Senekw/latch-knee/paper/latch_knee_paper.html

# LATCH: a load-sequence-sensing, any-angle stance-control knee joint for KAFOs — design and validation report

Design package and analysis report

October 2026

# Abstract

People with quadriceps paralysis (polio survivors, incomplete spinal-cord injury, stroke) usually walk in knee–ankle–foot orthoses (KAFOs) whose knee is locked straight for the whole gait cycle, forcing hip hiking, circumduction and vaulting. Stance-control knee joints that free the knee in swing cost US$1,700–3,500 per joint and the only purely mechanical ones either need a cable from the ankle or a gravity pendulum that locks only at full extension. We asked whether a knee joint can decide stance from swing using only the loads it already carries. Using a public multi-speed walking dataset (51 subjects, 381 treadmill trials, 0.34–2.23 m/s) we first showed that any pendulum trigger mounted on the thigh is corrupted by the knee’s own accelerations (up to 14 m/s^2 at toe-off), so that no pendulum length, mount height or damping achieved both reliable locking at heel strike and release before swing. We then designed a joint in which a fine-pitch ratchet (3.75^\circ resolution, locks at any knee angle) is engaged and released by the sign sequence of the external knee moment: a flexion load on the pawls sets a mechanical latch, a subsequent extension load on a sprung hyperextension stop releases the pawls, a friction drag ring on the knee axle keeps them lifted while the knee flexes in swing and drops them during swing extension, and two rotary dampers and a dashpot provide the required 0.1–0.3 s time constants. Simulated on 9,781 valid strides with a causal state machine driven by measured knee kinematics and inverse-dynamics moments, the design locked at heel strike in 99.2% of strides at speeds \le1.5 m/s, was unlocked while a buckling load was present in 0.27%, falsely blocked swing flexion in 0.23%, released before pre-swing flexion in 89.6% and never released in 3.6% (a safe, stiff-knee stride). The knee angle at heel strike in the dataset was 7.4\pm6.0^\circ (64% of strides >5^\circ), which quantifies why single-notch full-extension locks fail. The complete joint is modelled parametrically (22 components, STEP and STL supplied): a laser-cut steel load path (two phased toothed clevis plates, 3-tooth hook pawls, 12 mm pin) with 3D-printed control parts, bill of materials US$74, plane-stress FE peak tooth stress 250–280 MPa at the 70 N\cdotm design moment and 540–600 MPa at a 150 N\cdotm proof moment (17-4PH H900 yield 1,170 MPa). We give the full validation protocol for bench and gait-laboratory testing.

# Introduction

## The problem

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

## Stance-control joints and why they are rare

Stance-control knee–ankle–foot orthoses (SCKAFOs) lock the knee only while the leg bears weight and free it in swing. They normalise kinematics reliably even if the energy-cost benefit is modest [12, 13, 14, 6]. Commercial joints fall into three families. (i) Cable-released joints (Ottobock FreeWalk, Becker UTX/Stride family) unlock when the ankle dorsiflexes in late stance and lock only when the knee reaches full extension [6]; (ii) the Fillauer Swing Phase Lock (SPL2) uses an internal gravity pendulum that drops a pawl into a single notch at full extension when the thigh is inclined forward [15]; (iii) sensor-based electromechanical and microprocessor joints (E-MAG, NEURO TRONIC, C-Brace) that cost from €10,000 to US$37,000 as finished orthoses and still show 10–14% unlock failures per step under challenging conditions [16, 17, 18]. Bare mechanical joint systems list at about US$1,700 (FreeWalk kit) to £3,500 (SPL2) [19, 20]. The recurring engineering limitation identified by Yakimovich et al. is “dependence on specific joint angles to switch between stance and swing modes” [6]: a user who falls short of full extension in terminal swing is left unsupported [21]. Becker markets the SafetyStride specifically as resisting flexion at any angle [22]; research joints with any-angle capability have used hydraulics (69 N\cdotm [23]), a linear piston resisting >150 N\cdotm [24], a quasi-passive spring clutch [25], a three-tooth 10^\circ-pitch ratchet [21], and most recently a low-cost solenoid-driven serrated ring [26]. None of these is simultaneously any-angle, electronics-free, cable-free, pendulum-free and open.

## Contribution

This report presents LATCH (Load-Actuated, Thigh-Cable-free, any-angle stance-Control Hinge), a KAFO knee joint that decides stance from swing using only the external knee moment it already carries, with no pendulum, cable, battery or sensor. Three things are new. First, a data-driven negative result that motivates the design: driven by the measured kinematics of 51 subjects, a thigh-mounted pendulum cannot be made reliable at any length, mount height or damping (Section 3.1). Second, a load-sequence stance detector that is realisable with two springs, a friction ring, two rotary dampers and a dashpot, and whose per-stride performance we quantify on 9,781 strides across eight speeds (Section 3.2). Third, a complete parametric design package (CAD, finite-element sizing, bill of materials, assembly and validation protocol) that uses laser-cut steel for the load path and 3D printing for the control mechanism, at a parts cost of US$74 (Sections 4–5).

# Methods

## Gait data

We used the Fukuchi et al. public walking dataset [27] (“WBDS”; figshare 10.6084/m9.figshare.5722711, v3 release containing 51 adult subjects), restricted to its treadmill trials: eight speeds per subject (40–145% of comfortable speed), 30 s each, giving 381 trials with 150 Hz marker trajectories, 300 Hz split-belt force plates and gait-cycle-normalised joint moments from inverse dynamics. From the markers we computed, for the right leg, the thigh inclination from vertical \theta (greater trochanter to lateral knee marker), the knee flexion angle (thigh versus shank segments), and the position and acceleration of points on the lateral thigh upright 0–20 cm above the knee axis, after 8 Hz low-pass filtering. Right heel strikes and toe-offs were detected as force-plate contacts validated by the centre of pressure lying within 18 cm of the right heel and ankle markers. Strides with implausible stance fraction (<50\% or >72\% of the cycle) or duration (outside 0.6–2.4 s) were excluded, leaving 9,781 strides from 51 subjects at 0.34–2.23 m/s (mean body mass 67.8 kg). The knee moment curve of each trial (N\cdotm/kg; positive = internal extensor = external flexion load) was mapped onto each stride by percentage of cycle.

## Mechanism simulation

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

#### Pendulum trigger.

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

#### Load-sequence trigger (LATCH).

The joint has three mechanical inputs: the external flexion moment carried by the engaged pawls; the external extension moment carried by a sprung hyperextension stop with 1 mm of travel before a hard stop; and the direction of knee rotation sensed by a friction-drag ring on the knee axle with a dead band \delta. The logic (Fig. 2) is: (1) a pawl load above M_\mathrm{pawl} sets a LATCH that decays T_\mathrm{latch} after the pawl unloads (rotary damper); (2) a stop load above M_\mathrm{thr} while LATCH is set, or sustained for longer than T_\mathrm{long} (dashpot timer), lifts the pawls and keeps them lifted while the stop remains loaded; (3) the drag ring holds the pawls lifted while the knee flexes and lets them drop, after a delay t_\mathrm{drop} set by a second rotary damper, once the knee has extended by \delta; (4) the ratchet teeth cover knee angles -5^\circ to 30^\circ, so pawls dropped at larger flexion ride a smooth rim and engage on reaching the toothed sector. Thresholds are per kilogram of body mass and are set on the device by spring preload screws. The design point is M_\mathrm{thr}=0.05, M_\mathrm{pawl}=0.08 N\cdotm/kg, T_\mathrm{latch}=0.15 s, T_\mathrm{long}=0.30 s, \delta=15^\circ, t_\mathrm{drop}=0.10 s, t_\mathrm{lift}=0.03 s.

#### Outcome measures (per stride).

Locked at heel strike: pawls engaged at the next heel strike and 20 ms later. Buckling exposure: any instant before the pre-swing flexion onset at which the knee is unlocked while the external flexion moment exceeds 0.05 N\cdotm/kg. False lock: pawls engaged while the knee is flexing in swing. Released in time: pawls released before the knee needs to flex 5^\circ beyond its mid-stance minimum. Stiff stride: no release before toe-off (safe failure). We also report the release instant and the ratcheting travel (clicks) per stride.

## CAD, structural sizing and finite elements

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

# Results

## Why a single-notch lock fails and why a pendulum cannot fix it

Knee flexion at heel strike across the 9,781 strides was 7.4\pm6.0^\circ (5th–95th percentile -0.7 to 18.1^\circ); 64% of strides exceeded 5^\circ and 28% exceeded 10^\circ (Fig. 1A). A lock with a single notch at full extension therefore depends on the orthotist’s alignment and on the user reaching that one angle every step; an any-angle lock removes the dependence.

A gravity pendulum reads the direction of apparent gravity g-a, not of g. Fig. 1B shows, for one subject at 1.24 m/s, that the forward acceleration of the knee at toe-off (peaks of 9–14 m/s^2 at the knee, 5–7 m/s^2 20 cm up the thigh) tilts apparent gravity by 40–55^\circ and its deceleration in terminal swing by 20–40^\circ, in each case in the direction that mimics the opposite gait phase. Across the full sweep (Fig. 1C and sweep1.csv) the best pendulum for locking (8 cm, 20 cm mount, \zeta=3) locked at heel strike in 99.7% of strides but released before swing in only 2.5%; the best for releasing (3 cm at the knee, \zeta=0.3) released in 84% but engaged the ratchet during swing flexion in 53% of strides. Long pendulums (L_\mathrm{eff}\ge 20 cm) remove the thigh-rotation component but sit near resonance with the stride-frequency hip acceleration and miss the 130 ms release window. Slow, heavily damped pendulums are safe but functionally equivalent to a locked knee. This is the mechanism behind the alignment sensitivity reported for pendulum joints [15, 6], and it is a property of inertial sensing at the knee rather than of any particular product.

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

## The load-sequence stance detector

Fig. 2 shows the LATCH logic on a measured stride at 1.03 m/s. The pawls are engaged at heel strike. The initial-contact extension moment (the ground reaction passes in front of the knee for 50–80 ms) loads the stop but LATCH is not set, so nothing happens; during loading response the external flexion moment loads the pawls and sets LATCH; when the ground reaction moves in front of the knee at 23% of the cycle the stop is loaded while LATCH is live and the pawls lift. The knee is now free but rests against the extension stop, which carries an extension moment of 0.3–0.65 N\cdotm/kg through mid-stance: a knee under an external extension moment is self-stable, which is the biomechanical justification of releasing at this instant. At pre-swing the stop unloads and the knee flexes; the drag ring registers 15^\circ of flexion within the 100 ms pawl-drop delay and holds the pawls up through swing. At peak swing flexion the knee reverses, the ring releases the pawls after 15^\circ of extension, they ride the smooth rim and ratchet over the last 20^\circ (median 21.6^\circ of ratcheting, about six clicks at 3.75^\circ resolution) and the knee arrives at heel strike locked at whatever angle it reached.

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

Table 1 and Fig. 3 summarise performance. Within the speed range in which KAFO users walk (\le1.5 m/s; 7,278 strides, 51 subjects) the joint was locked at heel strike in 99.2% of strides, was exposed to a buckling load while unlocked in 0.27%, falsely blocked swing flexion in 0.23%, released before the knee needed to flex in 89.6%, released late but before toe-off in a further 6.8%, and never released (stiff-knee stride) in 3.6%. The median release instant was 28% of the cycle (5th–95th percentile 7–51%). Above 1.5 m/s performance degrades (locked at heel strike 89–93%, exposure 7–8%) through one specific chain: fast walkers develop a second external flexion moment in pre-swing that keeps the pawls loaded until toe-off, so LATCH is still live when the shank’s deceleration loads the stop in terminal swing and the joint releases just before heel strike. A hypothetical heel-strike impact detector that allowed LATCH to be set only within 0.5 s of heel strike would raise locking above 1.5 m/s to 98.2% and cut exposure to 0.9% at no cost in the envelope (Fig. 3C, lock_sensitivity.json); we list it as the first design iteration.

Per-stride performance of the design point. Envelope = speeds \le1.5 m/s. “Stiff” strides are counted in “not released in time”.
Speed band (m/s) | n | Locked at HS | Buckling exposure | False swing lock | Released in time | Stiff stride | Release (%GC)
0.50 | 873 | 94.6% | 0.0% | 0.6% | 93.2% | 3.4% | 14
0.69 | 1065 | 100.0% | 0.4% | 0.4% | 90.6% | 1.9% | 20
0.87 | 1188 | 99.3% | 0.0% | 0.5% | 86.4% | 3.1% | 32
1.06 | 1321 | 100.0% | 0.8% | 0.1% | 90.2% | 3.4% | 28
1.24 | 1445 | 99.7% | 0.3% | 0.1% | 87.0% | 6.2% | 29
1.43 | 1530 | 99.5% | 0.8% | 0.3% | 95.6% | 0.3% | 28
1.63 | 1234 | 89.1% | 7.7% | 4.6% | 92.5% | 5.3% | 25
1.79 | 1125 | 93.3% | 6.6% | 5.8% | 96.8% | 3.2% | 26
Envelope \le1.5 | 7278 | 99.2% | 0.27% | 0.23% | 89.6% | 3.6% | 28
All | 9781 | 97.2% | 2.0% | 1.5% | 91.5% | 3.4% | 28

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

The sensitivity study (Fig. 3C) gives three design rules. (i) Preload must err high: thresholds 30% too low reduce locking to 93.6% and raise exposure to 5.3%, whereas thresholds 30% too high keep 99.99% locking and 0.07% exposure at the price of 7.5% stiff strides; the preload screws should therefore be set from the user’s body mass and then backed off only until swing release is observed. (ii) The dashpot timer is essential: without it, strides whose loading-response flexion moment never exceeds M_\mathrm{pawl} (all slow walking, where the ground reaction stays in front of the knee) never release and 44% of envelope strides are stiff. (iii) The drag-ring dead band and pawl-drop delay are forgiving over \delta=10–20^\circ and t_\mathrm{drop}=60–150 ms, and a 0.3 N\cdotm/kg, 25 ms stop impulse at terminal swing (shank hitting the extension stop) changes nothing because LATCH is not live at that instant. Knee moment peaks in the dataset were 0.21 (median), 0.82 (95th) and 1.06 N\cdotm/kg (99th percentile) in flexion and 0.51/0.78 N\cdotm/kg in extension, which fixes the structural loads below.

# Mechanical design

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

## Load path

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

## Control deck (printed)

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

## Mass and cost

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

# Structural analysis

Design loads follow from Section 3.2 and the literature: a typical peak external flexion moment of 0.5 N\cdotm/kg (36 N\cdotm for 70 kg) for fatigue, the 99th-percentile 1.0 N\cdotm/kg (70 N\cdotm) as design moment, and 150 N\cdotm as proof moment, the latter matching the Ottawa piston joint that was designed for >150 N\cdotm and survived 400,000 cycles [24]. Plane-stress finite elements of the toothed plate (Fig. 6) give a von Mises stress at the loaded tooth roots of 250–280 MPa (99th–99.5th percentile of element stresses) at 70 N\cdotm and 540–600 MPa at 150 N\cdotm, with a sharp-corner singular maximum of 570 and 1,215 MPa respectively that a 0.4 mm root fillet removes. For 17-4PH H900 (yield 1,170 MPa, fully reversed fatigue limit about 550 MPa) or through-hardened 1095 this gives a yield safety factor of 2.0 at the proof moment and a fatigue safety factor above 3 at the typical load (root stress about 140 MPa). The analytical checks are: tooth tangential force 2,170 N at 70 N\cdotm; 6 mm pawl pin in double shear 38 MPa, bearing in the 6 mm thigh plate 60 MPa (129 MPa at proof); 12 mm knee pin resultant 3.1 kN, bronze bushing bearing 52 MPa per plate (93 MPa at proof); 16\times6 mm thigh upright in sagittal bending 273 MPa if one upright carries the full 70 N\cdotm (137 MPa when shared). The FE result also explains why the load path cannot be printed: FFF polyamide-12 and polycarbonate have fatigue limits of 7.4 and 3.6 MPa [28] and even short-carbon-fibre polyamide reaches only 40–117 MPa in tension [29], two orders of magnitude below the tooth-root stress.

Plane-stress FE of the toothed shank plate at the 70 N\cdotm design moment (left) and 150 N\cdotm proof moment (right); 6,348 quadratic triangles, fixed at the bushing seat, the tangential tooth force shared 50/30/20% over the three engaged flanks.

# Discussion

## What the simulation does and does not show

The simulation is a kinematic/kinetic replay: real knee angles and inverse-dynamics moments of unimpaired walkers drive a causal model of the mechanism, with the knee angle clamped while the lock is engaged. It therefore tests the decision logic against the full variability of 51 people at eight speeds, which no bench test can do, but it does not model how a KAFO user’s hip and trunk would adapt to the joint, nor the compliance of the orthosis shells, nor friction and wear. Three systematic differences from a KAFO user should bias the results in a known direction. Quadriceps-weak users keep the ground reaction in front of the knee by trunk lean and hyperextension, so their stance moment is extension-dominated: the latch path fires less often and the timer path more often, which the slow-speed rows of Table 1 already represent. Their swing is slower and lower, which lengthens the pre-swing window and favours release in time. Their knee hits the extension stop at terminal swing, which the impulse test covers. The one chain that limits fast-walking performance (pre-swing flexion load keeping LATCH live into terminal swing) is specific to vigorous push-off and is unlikely in the target population, but the heel-strike gate that removes it is a cheap addition (an inertia latch on the shank).

## Comparison with existing joints

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

## Limitations and next steps

The CAD is a detailed concept: springs, dampers and the dashpot are modelled as envelopes with specified characteristics, the plates are un-pocketed, and the 963 g mass must be reduced. The FE is two-dimensional and omits the pawl (sized analytically) and contact; a 3D contact model with a root fillet is the next analysis step. The validation protocol is: (1) static proof test to 150 N\cdotm and ultimate test to failure on an ISO 10328-style rig [30], with strain gauges on the pawl and stop lever to calibrate the two preloads; (2) 400,000-cycle fatigue test at 36 N\cdotm with lock–release cycling; (3) bench replay of the WBDS strides on a two-link knee simulator with a programmable moment actuator, which reproduces the exact inputs of this report; (4) gait-laboratory testing with KAFO users on level ground, ramps and stairs with the selector in AUTO and LOCK, measuring lock timing from joint instrumentation and comparing hip hiking, circumduction and oxygen cost with the users’ own locked KAFOs, as in [13, 12]; (5) field evaluation in an LMIC P&O service, where laser cutting and FFF printing are available and the US$74 parts cost matters most.

# Conclusion

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

# Data and code availability

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

# References

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
