Senekw/latch-knee/paper/latex_src/figures/render_layer_deck.png

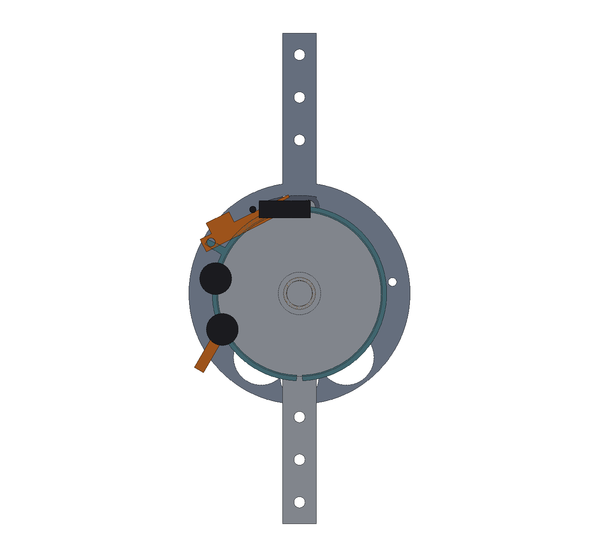
paper/latex_src/figures/render_layer_deck.png
