Senekw/latch-knee/renders/render_iso_open_k60.png

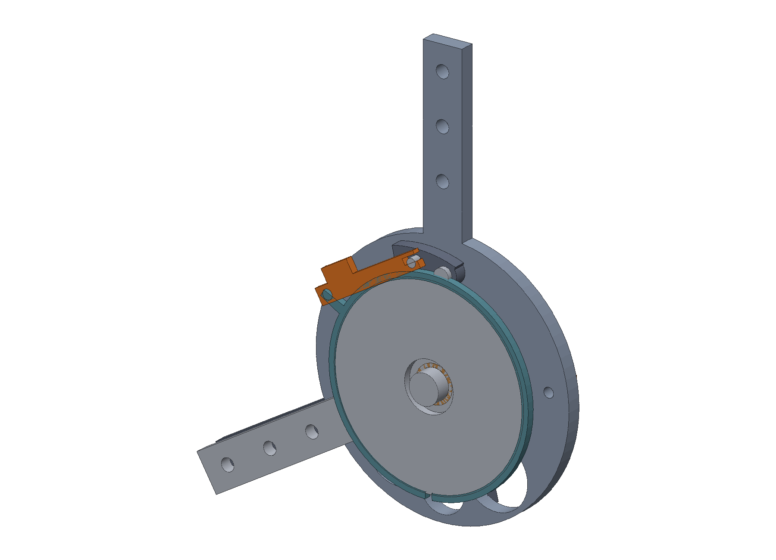
renders/render_iso_open_k60.png
