Senekw/latch-knee/cad/latch_knee_assembly.step

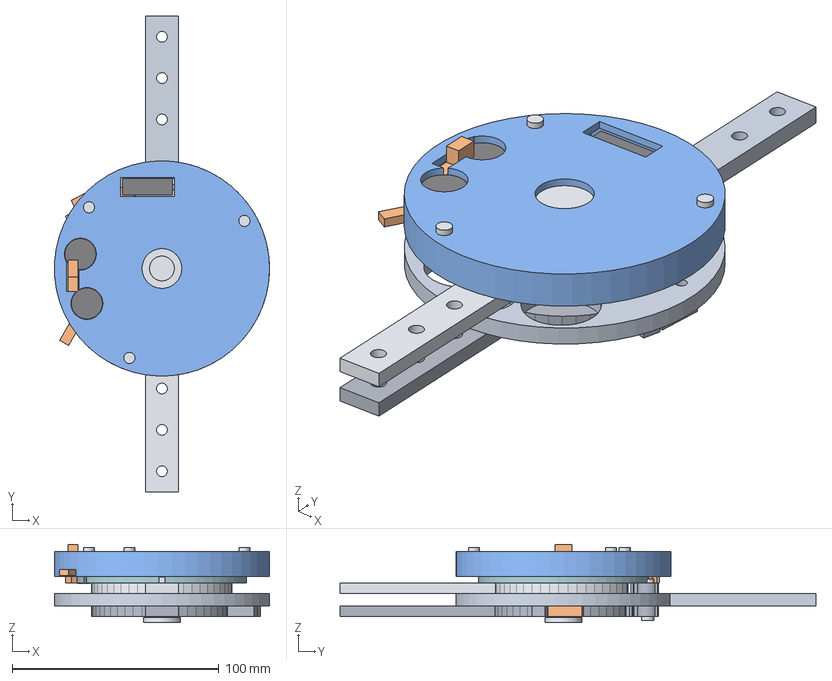
[picture p12: CAD file, 2026-10-03]
cad/latch_knee_assembly.step
103.9 x 230.0 x 37.7 mm
shank_plate_inner_ratchet
shank_plate_outer_ratchet
thigh_plate
pawl_A
pawl_B
pawl_pin
pawl_bridge_pin
knee_pin
bushing_inner
bushing_outer
stop_lever
lift_yoke
direction_ring
housing
damper_lift
damper_latch
timer_dashpot
latch_lever
mode_selector
screw_M3_30
screw_M3_140
screw_M3_250
