Senekw/latch-knee/cad/stl/pawl_A.stl

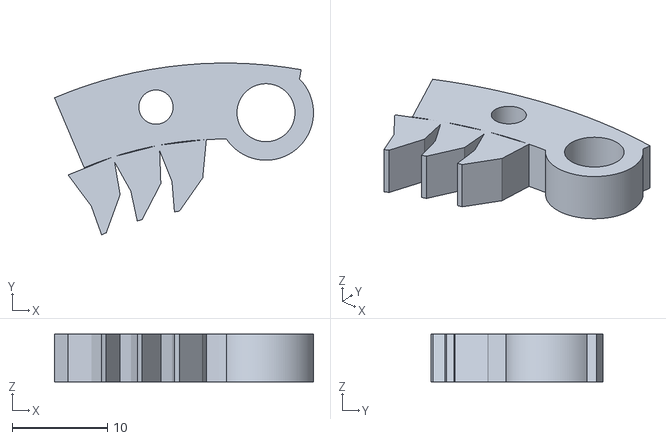
[picture p13: CAD file, 2026-10-03]
cad/stl/pawl_A.stl
27.3 x 18.1 x 5.00
