Senekw/latch-knee/cad/stl/pawl_pin_A.stl

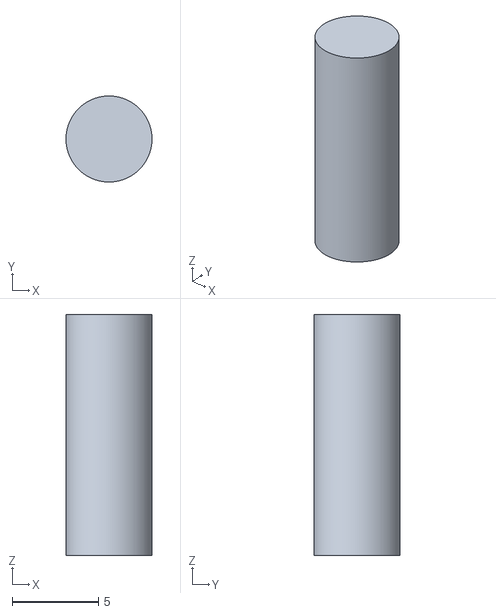
[picture p14: CAD file, 2026-10-03]
cad/stl/pawl_pin_A.stl
5.00 x 5.00 x 14.0
