Senekw/latch-knee/cad/stl/housing.stl

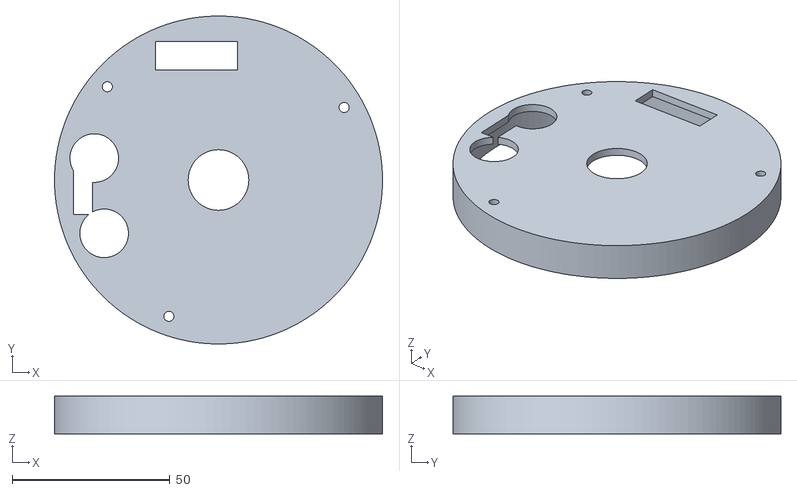
[picture p15: CAD file, 2026-10-03]
cad/stl/housing.stl
104.0 x 104.0 x 12.0
