Senekw/latch-knee/cad/stl/bushing_outer.stl

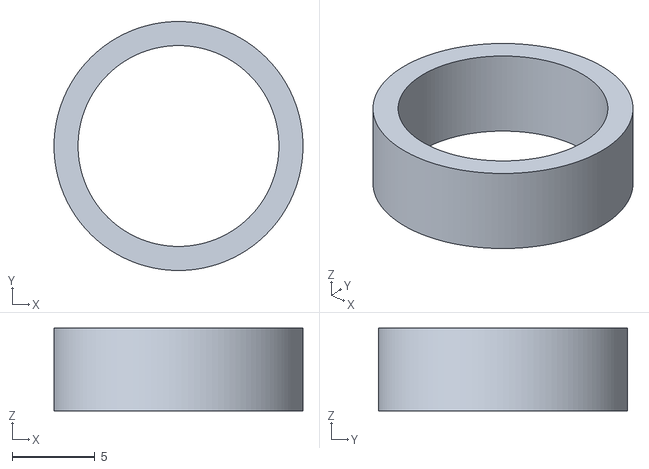
[picture p16: CAD file, 2026-10-03]
cad/stl/bushing_outer.stl
15.0 x 15.0 x 5.00
