Senekw/latch-knee/cad/stl/latch_lever.stl

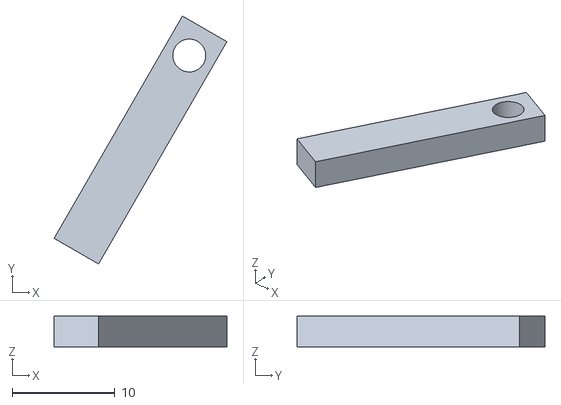
[picture p17: CAD file, 2026-10-03]
cad/stl/latch_lever.stl
16.8 x 24.2 x 3.00
