Senekw/latch-knee/cad/stl/pawl_pin.stl

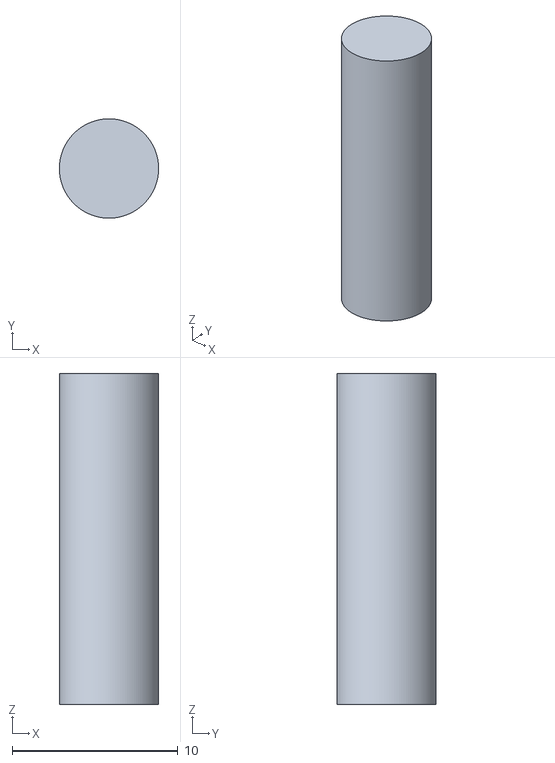
[picture p18: CAD file, 2026-10-03]
cad/stl/pawl_pin.stl
6.00 x 6.00 x 20.0
