Senekw/latch-knee/cad/stl/mode_selector.stl

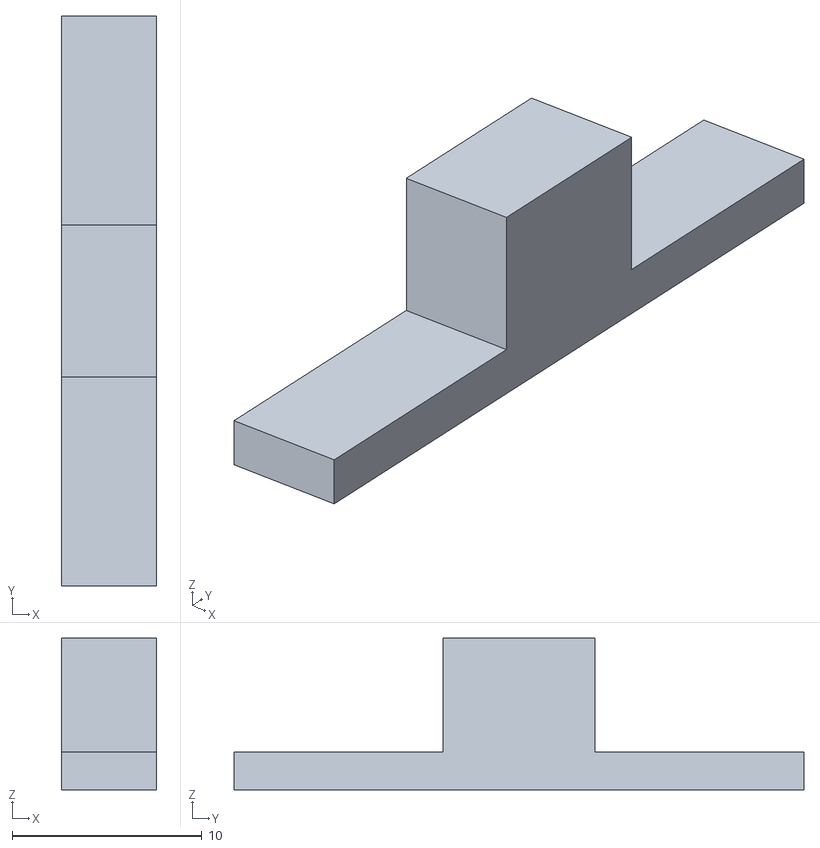
[picture p19: CAD file, 2026-10-03]
cad/stl/mode_selector.stl
5.00 x 30.0 x 8.00
