Senekw/latch-knee/cad/stl/pawl_bridge_pin.stl

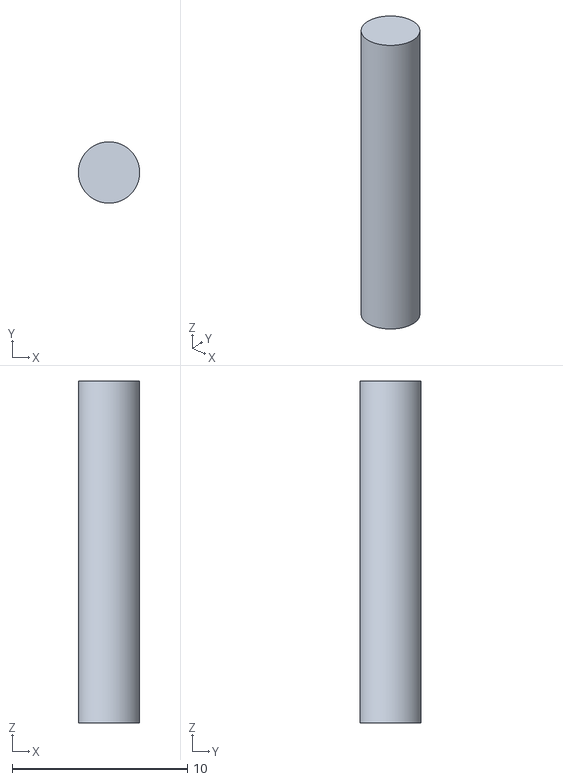
[picture p20: CAD file, 2026-10-03]
cad/stl/pawl_bridge_pin.stl
3.50 x 3.50 x 19.5
