Senekw/latch-knee/cad/stl/damper_lift.stl

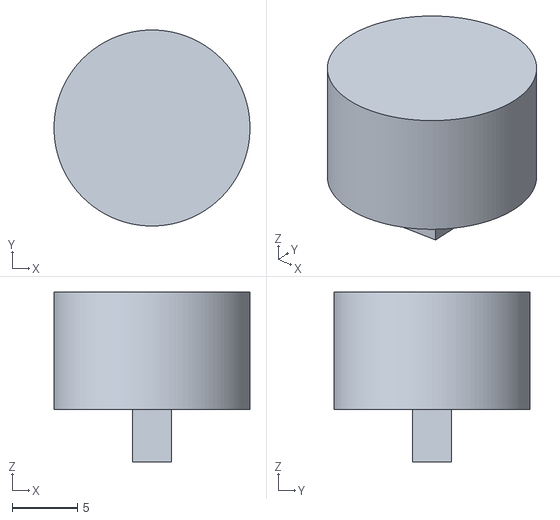
[picture p21: CAD file, 2026-10-03]
cad/stl/damper_lift.stl
15.0 x 15.0 x 13.0
