Senekw/latch-knee/cad/stl/shank_plate_inner_ratchet.stl

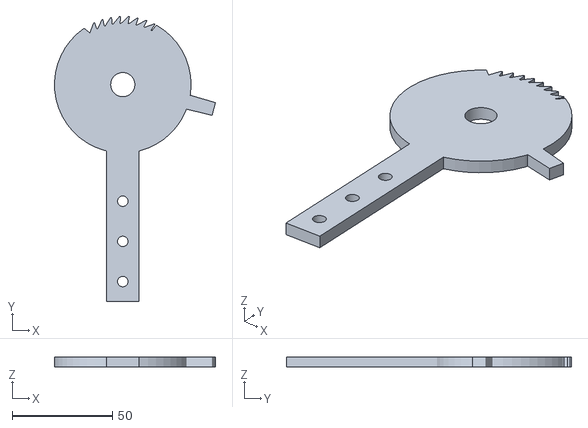
[picture p22: CAD file, 2026-10-03]
cad/stl/shank_plate_inner_ratchet.stl
80.1 x 142.0 x 5.00
