Senekw/latch-knee/cad/stl/timer_dashpot.stl

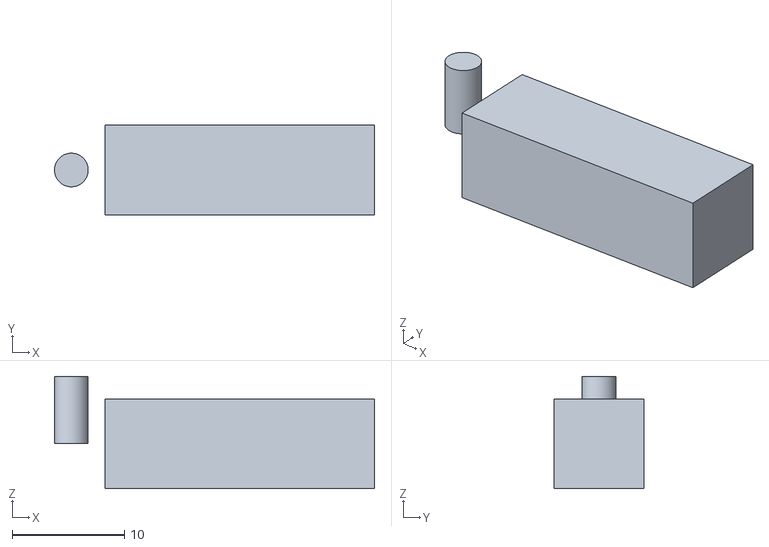
[picture p23: CAD file, 2026-10-03]
cad/stl/timer_dashpot.stl
28.5 x 8.00 x 10.0
