Senekw/latch-knee/cad/stl/lift_yoke.stl

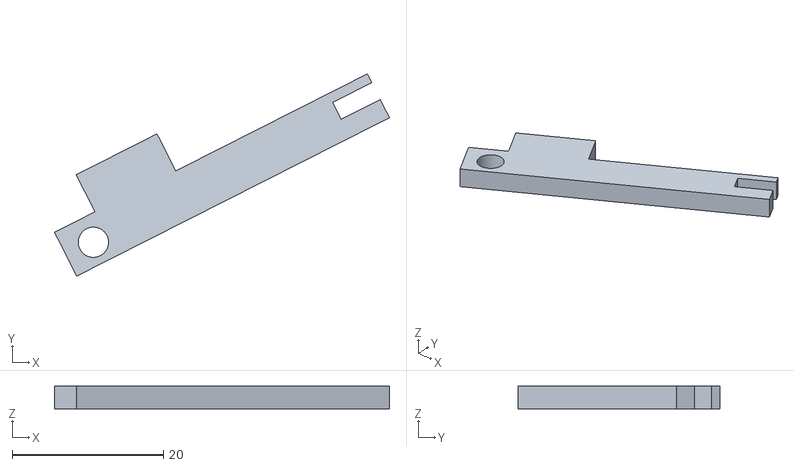
[picture p24: CAD file, 2026-10-03]
cad/stl/lift_yoke.stl
44.3 x 26.8 x 3.00
