Senekw/latch-knee/cad/stl/thigh_plate.stl

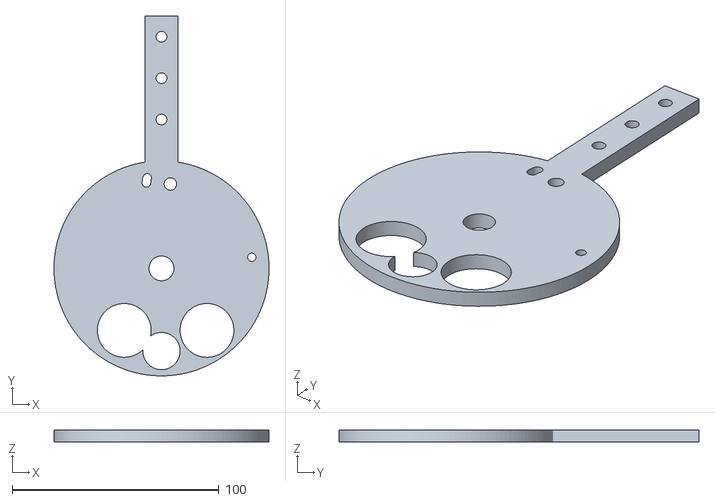
[picture p25: CAD file, 2026-10-03]
cad/stl/thigh_plate.stl
104.0 x 174.0 x 6.00
