Senekw/latch-knee/cad/stl/shank_plate_outer.stl

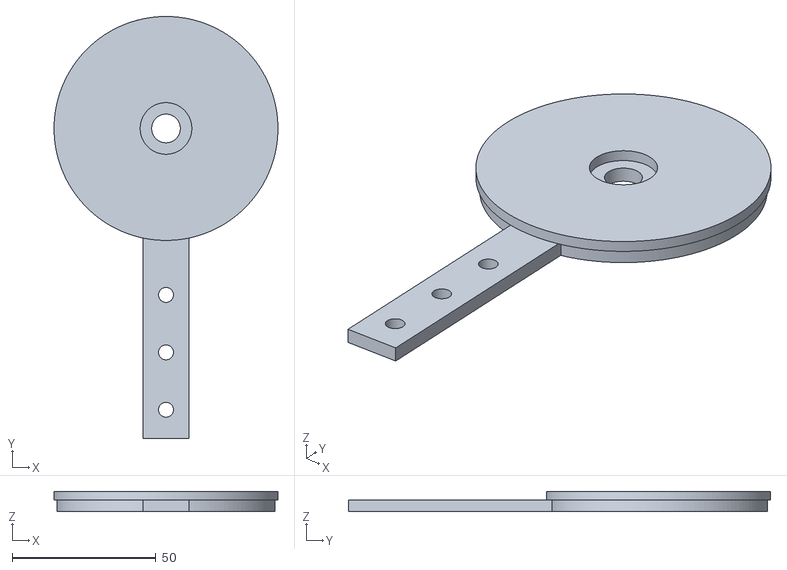
[picture p26: CAD file, 2026-10-03]
cad/stl/shank_plate_outer.stl
78.0 x 147.0 x 7.00
