Senekw/latch-knee/cad/stl/knee_pin.stl

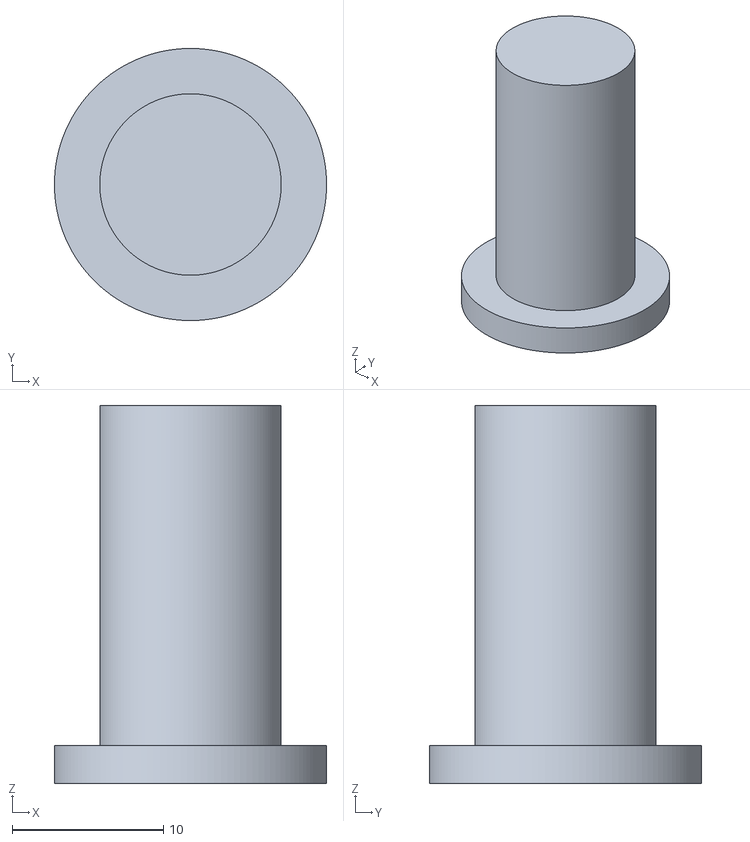
[picture p27: CAD file, 2026-10-03]
cad/stl/knee_pin.stl
18.0 x 18.0 x 25.0
