Senekw/latch-knee/cad/stl/direction_ring.stl

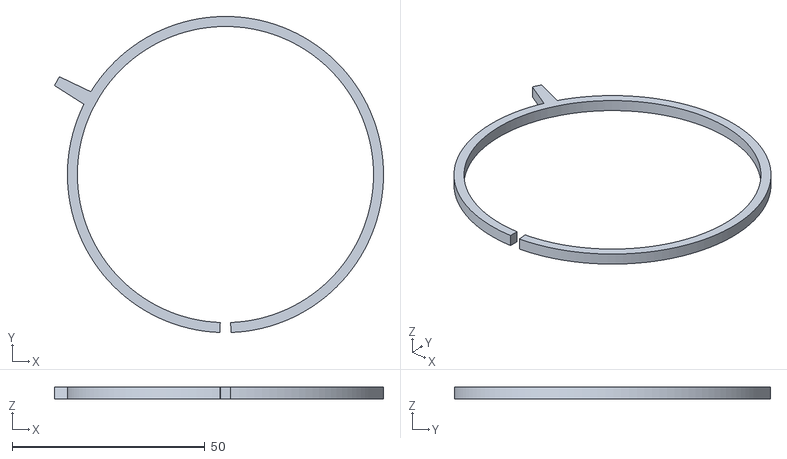
[picture p28: CAD file, 2026-10-03]
cad/stl/direction_ring.stl
85.3 x 82.0 x 3.00
