Senekw/latch-knee/cad/stl/shank_plate_outer_ratchet.stl

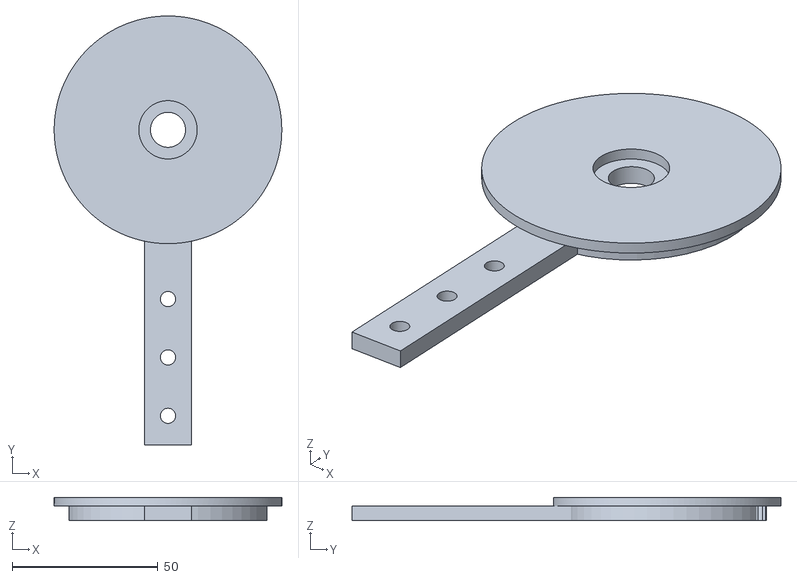
[picture p29: CAD file, 2026-10-03]
cad/stl/shank_plate_outer_ratchet.stl
78.0 x 147.0 x 8.00
