Senekw/latch-knee/cad/stl/stop_lever.stl

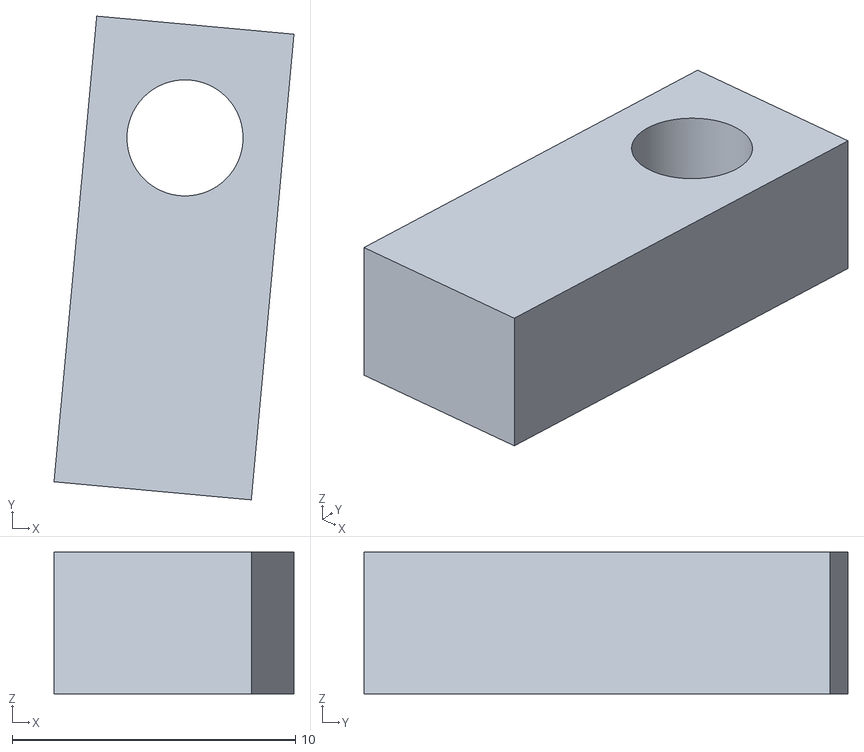
[picture p30: CAD file, 2026-10-03]
cad/stl/stop_lever.stl
8.48 x 17.1 x 5.00
