Senekw/latch-knee/(list of files, cad)

Other CAD files:
cad/stl/damper_latch.stl
cad/stl/pawl_B.stl
cad/stl/bushing_inner.stl
cad/stl/pawl_pin_B.stl
cad/stl/screw_M3_140.stl
cad/stl/screw_M3_250.stl
cad/stl/screw_M3_30.stl
