Senekw/latch-knee/results/sweep1.csv

n_strides | n_subj | locked_at_hs | false_lock | released | released_in_time | early_release | held_through_swing | lock_margin_p5_ms | lock_margin_med_ms | clicks_deg_med | spl_would_lock | L_eff | s | zeta | fail
10008 | 51 | 0.9583333333333334 | 0.5937250199840128 | 0.99310551558753 | 0.7888689048760992 | 0.6252997601918465 | 0.006894484412470024 | 26.666666666667282 | 263.33333333333366 | 53.05978690628709 | 0.357414068745004 | 0.03 | 0.0 | 0.3 | 0.8465227817745803
10008 | 51 | 0.8798960831334932 | 0.6186051159072742 | 0.9729216626698641 | 0.8255395683453237 | 0.518185451638689 | 0.027078337330135892 | 23.333333333333428 | 270.0 | 53.82877688268644 | 0.357414068745004 | 0.03 | 0.0 | 0.7 | 0.9131694644284573
10008 | 51 | 0.6885491606714629 | 0.45443645083932854 | 0.8878896882494005 | 0.6214028776978417 | 0.40047961630695444 | 0.11211031175059952 | 29.999999999999915 | 279.9999999999994 | 54.76131527356714 | 0.357414068745004 | 0.03 | 0.0 | 1.5 | 1.144484412470024
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
