Senekw/latch-knee/results/sweep2.csv

n | locked_at_hs | false_lock | released_in_time | early_release | stiff | t_rel_med | t_rel_p5 | t_rel_p95 | t_need_med | lock_margin_p5 | clicks_med | L_eff | s | zeta | fail
10008.0 | 0.453 | 0.289 | 0.641 | 0.4 | 0.358 | 27.444 | 9.69 | 91.746 | 49.168 | 146.667 | 55.19 | 0.03 | 0.0 | 0.5 | 1.5949999999999998
10008.0 | 0.369 | 0.316 | 0.675 | 0.358 | 0.322 | 27.632 | 9.622 | 91.722 | 49.168 | 150.0 | 55.263 | 0.03 | 0.0 | 1.0 | 1.63
10008.0 | 0.44 | 0.243 | 0.52 | 0.283 | 0.478 | 28.826 | 9.565 | 92.15 | 49.168 | 153.333 | 55.241 | 0.03 | 0.0 | 2.0 | 1.5659999999999998
10008.0 | 0.512 | 0.301 | 0.673 | 0.369 | 0.324 | 27.215 | 9.716 | 91.448 | 49.168 | 140.0 | 55.033 | 0.03 | 0.1 | 0.5 | 1.4849999999999999
10008.0 | 0.477 | 0.268 | 0.598 | 0.273 | 0.399 | 28.814 | 9.639 | 91.901 | 49.168 | 146.667 | 55.135 | 0.03 | 0.1 | 1.0 | 1.4660000000000002
10008.0 | 0.63 | 0.163 | 0.358 | 0.141 | 0.64 | 31.716 | 9.689 | 92.082 | 49.168 | 153.333 | 55.277 | 0.03 | 0.1 | 2.0 | 1.316
10008.0 | 0.667 | 0.289 | 0.693 | 0.318 | 0.301 | 27.302 | 9.787 | 90.857 | 49.168 | 130.0 | 54.484 | 0.03 | 0.2 | 0.5 | 1.2469999999999999
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
