Senekw/latch-knee/results/sweep_seq.csv

n | locked_at_hs | exposure | exp_ms_p95 | exp_deg_p95 | false_lock | released_in_time | stiff | t_rel_med | t_rel_p5 | t_rel_p95 | clicks_med | M_thr | M_pawl | TL | delta | t_drop
10008.0 | 0.838 | 0.206 | 80.0 | 10.941 | 0.056 | 0.847 | 0.152 | 26.623 | 0.0 | 38.566 | 23.29 | 0.03 | 0.02 | 0.0 | 10 | 0.08
10008.0 | 0.837 | 0.207 | 80.0 | 11.053 | 0.056 | 0.847 | 0.152 | 26.642 | 0.0 | 38.566 | 23.217 | 0.03 | 0.02 | 0.0 | 10 | 0.12
10008.0 | 0.834 | 0.201 | 80.0 | 11.041 | 0.056 | 0.848 | 0.152 | 26.524 | 0.0 | 38.409 | 23.276 | 0.03 | 0.02 | 0.0 | 12 | 0.08
10008.0 | 0.839 | 0.202 | 80.0 | 11.057 | 0.055 | 0.848 | 0.152 | 26.616 | 0.0 | 38.55 | 22.851 | 0.03 | 0.02 | 0.0 | 12 | 0.12
10008.0 | 0.837 | 0.193 | 53.333 | 10.253 | 0.054 | 0.849 | 0.151 | 26.537 | 0.0 | 38.307 | 23.107 | 0.03 | 0.02 | 0.0 | 15 | 0.08
10008.0 | 0.839 | 0.196 | 60.0 | 10.356 | 0.052 | 0.849 | 0.151 | 26.621 | 0.0 | 38.382 | 21.62 | 0.03 | 0.02 | 0.0 | 15 | 0.12
10008.0 | 0.882 | 0.234 | 111.0 | 11.013 | 0.032 | 0.979 | 0.01 | 25.455 | 0.194 | 39.024 | 22.255 | 0.03 | 0.02 | 0.3 | 10 | 0.08
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
